truongnt/balance_bot/docs/encoder-slot-sensor.jpg

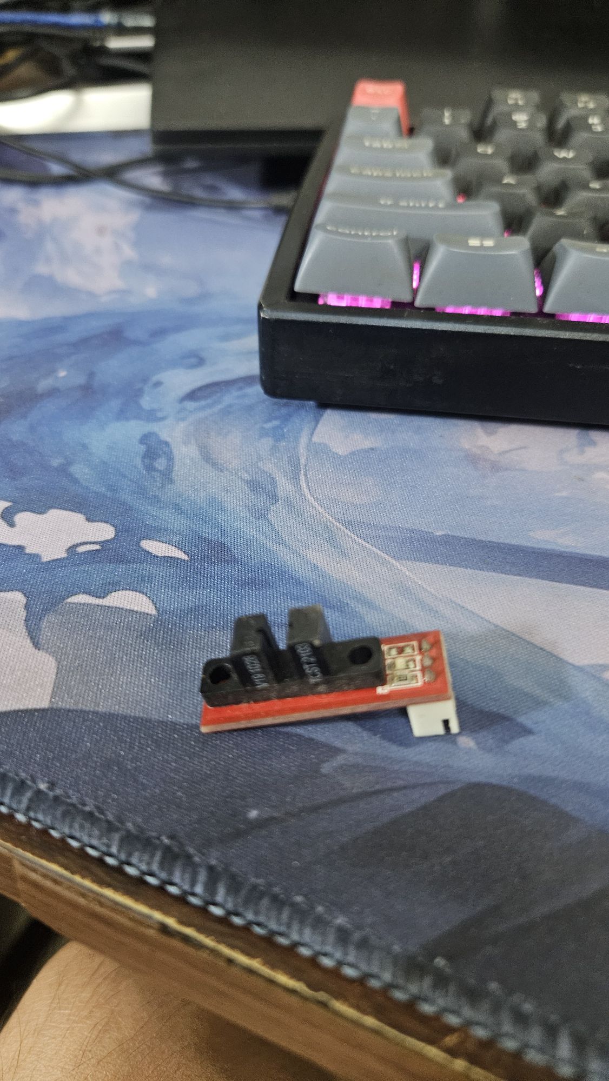
docs/encoder-slot-sensor.jpg
