truongnt/balance_bot/logs/robot_20261025_141032_push_test_raw.tsv

ms | angle | accel | target | gyro | speed | stepsL | stepsR
700331 | -0.39 | -1.37 | -0.59 | 5.8 | -73 | 245 | 290
700341 | -0.38 | -1.00 | -0.59 | 3.2 | -91 | 245 | 290
700351 | -0.36 | -0.59 | -0.59 | 2.8 | -109 | 244 | 289
700361 | -0.40 | -0.48 | -0.59 | -3.7 | -109 | 243 | 288
700370 | -0.48 | -0.53 | -0.59 | -8.5 | -92 | 242 | 287
700381 | -0.57 | -0.28 | -0.59 | -9.1 | -71 | 241 | 286
700391 | -0.65 | -0.18 | -0.59 | -10.4 | -42 | 240 | 285
700401 | -0.75 | -0.20 | -0.58 | -11.6 | -5 | 240 | 284
700411 | -0.82 | -0.56 | -0.58 | -7.7 | 24 | 241 | 284
700421 | -0.85 | -0.66 | -0.58 | -3.1 | 44 | 241 | 284
