truongnt/balance_bot/(commit log)

2026-10-26 Initial commit: self-balancing two-wheeled robot
    Arduino firmware (robot_balance.ino) plus a Windows Python console for live
    telemetry and live PID tuning over Bluetooth. Cascaded control: angle loop at
    100Hz inside a velocity loop at 10Hz inside a position loop, with Timer1 ISR
    step generation.
    Everything tunable is reachable over Bluetooth and persisted in EEPROM, so
    tuning never needs a USB upload. Parameters and telemetry fields are both
    driven by PROGMEM tables, and the PC side discovers the telemetry columns from
    the firmware's #COLS line rather than holding its own list.
    CLAUDE.md carries the measurements behind each value and the reasoning for the
    non-obvious ones, including why th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
    [robot_20261021_162444_baseline_parked_raw.tsv, robot_20261021_171509_vib_idle_raw.tsv, robot_20261021_171509_vib_spd320_raw.tsv, robot_20261021_171509_vib_turn300_raw.tsv, robot_20261022_110325_vib2_idle_raw.tsv, robot_20261022_110325_vib2_spd320_raw.tsv, robot_20261022_110325_vib2_spd640_raw.tsv, robot_20261022_110325_vib2_spd800_raw.tsv]
2026-10-26 Add README
    Orients a first-time visitor: the measured results, the hardware, how to flash
    and connect, and the repository layout.
    Leads with the three findings that would cost someone else the most time to
    rediscover — that a stepper commanded at constant speed exerts no force, that
    this robot's centre of mass is too low for leaning to drive it past the motors'
    detent torque, and that a mis-measured gyro bias is what turns a robot holding
    position to 0.5mm into one that runs a metre and falls.
    Points at CLAUDE.md for the full measurement record rather than restating it.
2026-10-26 Add build photographs to the README
    Four shots of the robot: front, side, top and rear. The top and rear pair are
    captioned, because they show the one mechanical decision a reader is most likely
    to reverse — the battery hanging low between the motors rather than sitting on
    the top deck.
    Raising it was computed and rejected. The rigid-body pole peaks at L = k, so
    moving the pack up lands almost exactly on the worst case and makes the robot
    less stable, not more. The point-mass intuition says the opposite.
    Also saved the slot-sensor photo from the encoder investigation. A vendor product
    photo carrying their watermark is kept locally but gitignored rather than
    republished here.
    Co-Authored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
2026-10-26 Add a browser control panel
    robot_ui.py holds the RFCOMM socket and serves a page on localhost: live
    readouts, a rolling plot of angle against target, a D-pad on the arrow keys,
    config buttons and a slider per parameter. Server side is standard library only.
    It has to work this way round because a browser cannot open Bluetooth, so the
    socket stays in Python and the page talks to it over 127.0.0.1.
    The panel holds no list of parameters or telemetry columns. It sends P on
    connect, builds a control per parameter using the firmware's own min/max as the
    slider bounds, and takes its columns from #COLS — the same contract
    robot_control.py follows, so a new PARAMS row shows up here with no chang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
2026-10-26 Fix the stop command, log every sample, add a link watchdog
    Three defects, all found by the robot rather than by reading the code.
    The stop button made the robot drift and fall. S still cleared pidI_vel, and
    under the architecture adopted on 2026-10-25 that integral IS the level trim:
    target = BIAS + Kp_vel*vel_err + Ki_vel*pidI_vel. Clearing it drops target by
    about 0.5 degrees instantly, and Ki_vel 0.001 at 10Hz needs tens of seconds to
    build it back. F/B/DRIVE were fixed that morning; S, BIAS and BIASADJ were
    missed. VDIR still clears it, correctly, because flipping vel_dir leaves the
    accumulated integral with the wrong sign.
    The panel's stop button now sends DRIVE 0 + TURN 0 instead of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
    [robot_20261026_175843_ui_raw.tsv, robot_20261026_180329_ui_raw.tsv]
2026-10-26 Pulse the turn command, and analyse the newest segment
    One press of the turn pad used to spin the robot until it was stopped, because
    L/R set a turn rate that holds. Measured: TURN 200 held for three seconds is a
    full quarter turn. The pad now sends TURN n followed by TURN 0 after an
    adjustable interval, so a press is a repeatable turn amount — about 6 degrees at
    400ms and TRNSTEP 100. Drive stays latching, since driving is something you hold.
    analyze_log.py gains --last. It analyses the longest contiguous block by default,
    which is right for dissecting a finished session and wrong while tuning: after a
    reboot the segment that matters is the one just recorded, and it is usually the
    shorte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
    [robot_20261026_180329_ui_raw.tsv, robot_20261026_180900_ui_raw.tsv]
2026-10-26 Drive by commanding wheel speed, not by leaning
    Forward and back did nothing. The command arrived and the velocity loop did
    exactly what it was told — target settled at 0.74 degrees, which is
    Kp_vel*30 + Ki_vel*500 to two decimals, the integral pinned against its clamp.
    Raising KIV moved target to 2.16 and then 3.16 degrees, matching the formula
    each time, and the robot still travelled 0.15cm in four seconds.
    So yesterday's detent explanation was wrong in a way that mattered. 10-16 mN.m
    is the detent torque of an unpowered NEMA17. While balancing the motors are
    energised and holding position, which is 0.18 N.m; the toppling torque at 3.16
    degrees is 32 mN.m. Gravity would need about 18 de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
    [robot_20261026_180900_ui_raw.tsv]
2026-10-26 Add upload.py so a flash cannot hang silently
    Two devices on this machine answer to COM7: the board (VID:PID 0843:5740) and a
    leftover Bluetooth incoming port. Opening a Bluetooth virtual port with nothing
    connected blocks indefinitely, with no error and no timeout, so avrdude simply
    stops. A plain serial.Serial.open() on COM7 hangs the same way.
    This was already known. It was found and written into CLAUDE.md on 2026-10-25
    as a trap on this machine, and then bare `-p COM7` was used again anyway. Two
    uploads happened to resolve to the board that morning and that was treated as
    the problem being over; five consecutive attempts later hung.
    upload.py resolves the board by VID:PID rather than b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
    [robot_20261026_180900_ui_raw.tsv]
2026-10-26 Record what actually cleared the COM port collision
    Disabling the duplicate Bluetooth port is necessary but not sufficient. After
    the disable, avrdude stopped hanging and started reporting "unable to open port
    COM7" instead: a disabled device keeps the name claimed until the board
    re-enumerates. Unplugging and replugging the USB cable released it, and the
    upload then succeeded on the first attempt.
    upload.py's warning said a duplicate makes the port a coin toss, which was wrong
    in two directions. Resolution turned out to be deterministic, not random, and a
    duplicate that is already disabled is harmless — list_ports reads the registry,
    so a disabled entry still appears. The warning now dis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
    [upload.py]
2026-10-26 Compile and upload in one command, never upload alone
    The flash reported success and ran old code. `arduino-cli upload` does not
    compile; it re-flashes whatever is in the build cache, and the cache is keyed by
    a hash of the sketch path. upload.py passed "D:\Project\robot_balance" while the
    compiles had used "d:\Project\robot_balance" — a case difference is a different
    hash and a different cache. There are five such directories on this machine.
    Nothing on the surface showed it. The upload printed "New upload port: COM7" and
    exited 0, and the parameters all read back correctly, because they predate the
    change. Telemetry is what caught it: speed tracked ctrlout to within one step/s
    in every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
    [robot_20261026_185823_ui_raw.tsv]
2026-10-26 Make the upload docstring raw so it stops warning on a path backslash
    [robot_20261026_185823_ui_raw.tsv]
2026-10-26 Measure the damping gain: KD 6, not 2.5
    The oldest open complaint on this robot was that a shove makes it drift. The
    derivation put the damping ratio near 0.17 at kd 2.5, which is what that looks
    like, but it had never been tested. Three values, forty seconds each, live over
    Bluetooth with no reflashing:
    kd 2.5 angle sigma 0.111 peak 1.46 speed sigma 139 0.6 Hz
    kd 6.0 angle sigma 0.051 peak 0.72 speed sigma 38 6.6 Hz
    kd 10 fell after 11 seconds
    kd 6 is better on every measure at once. The spectrum is the part that matters:
    at kd 2.5 the peak sits at 0.6 Hz, the same oscillation recorded on 2026-10-22
    and attributed then to the outer velocity loop. At kd 6 it is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
    [robot_20261026_185823_ui_raw.tsv, robot_20261026_192734_ui_raw.tsv]
2026-10-27 Recalibrate the gyro, cap the speed, and retract a false alarm
    Mining a clean kd 6 segment gave gyro averaging +1.392 deg/s and drift +0.453
    degrees. The complementary filter's steady-state error for that bias works out
    to 0.450 degrees, so angle was reading a fixed 0.45 high purely from
    calibration. Holding position against that costs Ki_vel * pidI_vel = 0.45, i.e.
    about 450 of a 500 clamp — which is why ivel read a pinned +500 every time it
    was inspected, and why driving through the velocity loop stalled at 0.74
    degrees of lean. The budget was already spent. After cal: gyro -0.008, drift
    -0.003.
    SPD drops to 2000. Normal balancing peaks at 333 and the 99th percentile across
    every sessio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
    [robot_20261026_192734_ui_raw.tsv, robot_20261027_104456_ui_raw.tsv]
2026-10-27 Add a VER command, and record that the board's flash no longer accepts writes
    Every upload today reported "bytes of flash written", "Avrdude done", exit 0,
    and left the chip running the previous program. Three conclusions were drawn
    from behaviour before this was pinned down.
    FW_VERSION plus a VER command exists now so the question "which firmware is
    running" is a one-second query instead of an inference. After a successful-
    looking upload the chip answered "? VER".
    The proof chain, once the logs were actually read: arduino-cli passes -V so
    avrdude never verifies; forcing verification fails because reading flash back
    returns a constant 0x62 at every address, so this bootloader does not imp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
    [robot_20261027_104456_ui_raw.tsv]
2026-10-27 Put the firmware version in the boot banner
    The version was queryable with VER, which still required a tool and a session.
    Printing it in the banner means opening the Serial Monitor after an upload
    answers 'which firmware is on the chip' directly, in the IDE the upload was
    done from.
2026-10-27 Confirm the unwritable flash is the board, not the toolchain
    Every external factor was eliminated and none was the cause. The duplicate COM
    name was real and had to be fixed -- it caused hangs and Access-is-denied -- but
    after renumbering the board to a unique COM12, moving it to a direct USB port,
    killing every process holding the port and running compile --upload in one
    invocation, a 2024-byte sketch still reported written and the board still booted
    the old firmware.
    A second board settled it. A genuine Mega 2560 on the same PC, cable and
    toolchain took the same test sketch and ran it immediately. The toolchain is
    fine; the Uno clone's flash is not writable.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
    [robot_20261027_120742_ui_raw.tsv]
2026-10-27 Fix flashing: the chip is an ATmega328PB, reflash the bootloader over ISP
    The MCU is an ATmega328PB (signature 1E 95 16), not the ATmega328P the toolchain
    was told about. Optiboot reports a hard-coded 1E 95 0F over the bootloader
    regardless of the silicon, so avrdude saw the part it expected, wrote, and
    reported success while nothing changed. Only reading the signature over ISP,
    which asks the hardware, showed the real part.
    Reflashed over ISP with -p atmega328pb: chip erase, Uno fuses, optiboot, lock
    0x0F. Normal USB uploads work again, confirmed by the version string moving from
    2026-10-27a-drive to 2026-10-27b.
    Two details worth keeping. At the stock ArduinoISP clock the signature read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
    [robot_balance.ino]
